kaiser-factorial/ducati-relay/v3_relay6/esp_relay_pinout.png

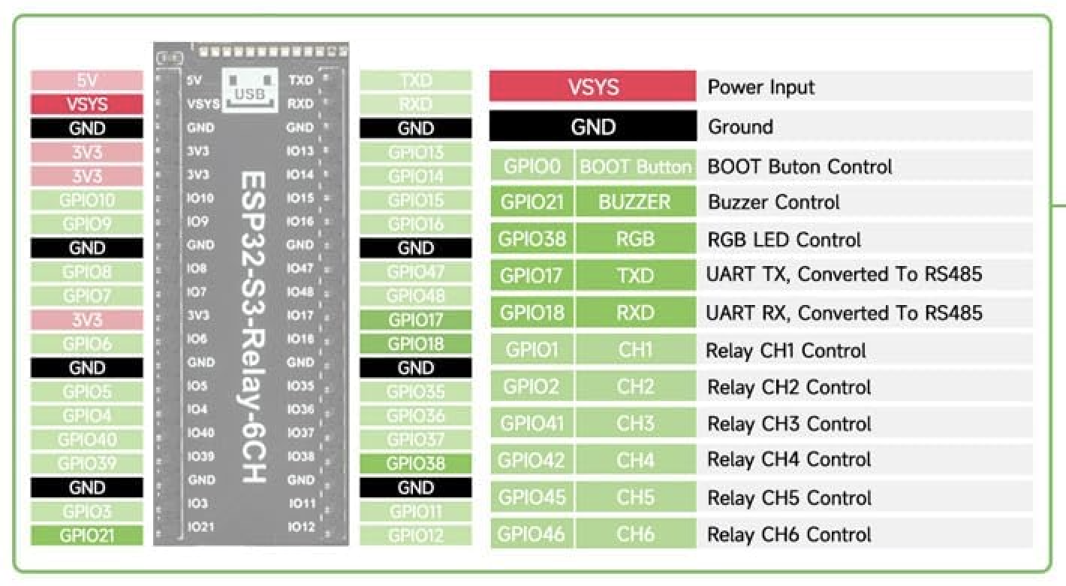
v3_relay6/esp_relay_pinout.png
