kaiser-factorial/ducati-relay/v3_relay6/can_hat_pinout.jpeg

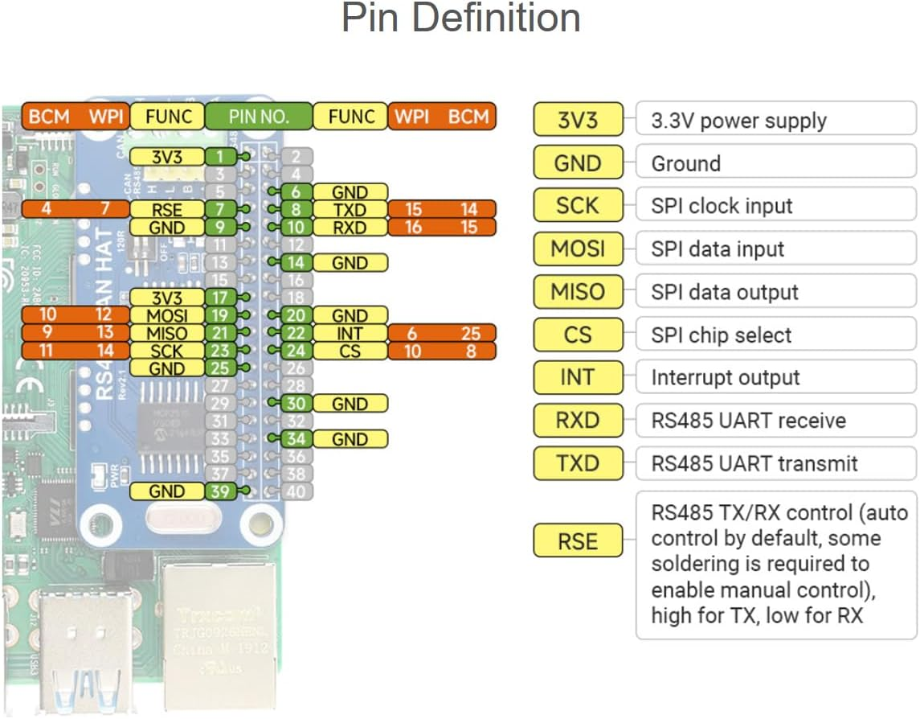
v3_relay6/can_hat_pinout.jpeg
