kaiser-factorial/ducati-relay/v3_relay6/front_CANhat_pinout.rtf

CAN --> ESP32

5V (2) --> 5V

3v3 (1) --> 3v3

MOSI (19) --> GPIO 7

MISO (21) --> GPIO 14

SCK (23) --> GPIO 6

GND (25) --> GND

INT (22) --> GPIO 15

CS (24) --> GPIO 16
