kaiser-factorial/ducati-relay/v3_relay6/esp_relay.jpeg

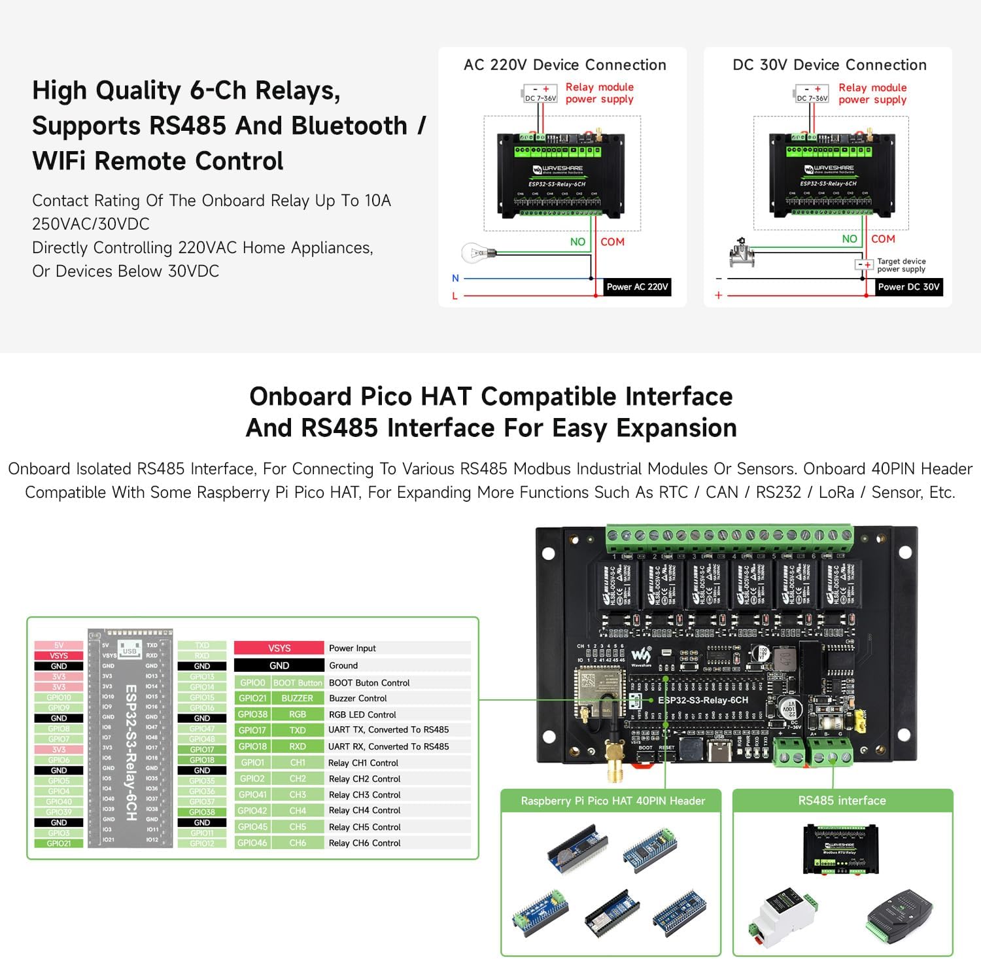
v3_relay6/esp_relay.jpeg
