kaiser-factorial/ducati-relay/(commit log)

2026-06-09 add v2 bike firmware for ESP-A and ESP-B
    ESP-A: 7 buttons (4 toggle, 1 momentary), 4 local front relays, CAN commands
    to ESP-B for turn signals and stereo; ignition-off shuts down all outputs;
    turn signals are mutually exclusive; starter has ignition interlock; receives
    ESP-B status and stubs ECU telemetry receive path.
    ESP-B: 4 rear relays with software turn-signal flash (500ms half-period),
    brake light stub (disabled, ECU_BRAKE_CAN_ID = 0x000 until rusEFI IDs
    confirmed), logical/physical relay state split, status broadcast on 0x160.
    Both sketches keep the same debug logging style as v1.
2026-06-09 fix CAN ID conflicts and add rusEFI telemetry parsing
    Move ESP-A command IDs from 0x100–0x102 to 0x300–0x302 to avoid collision
    with rusEFI's TunerStudio-over-CAN (0x100, 0x102). Update ESP-B relay table
    to match.
    Add ECU telemetry parsing in ESP-A's handleIncoming(): RPM (0x201), TPS
    (0x202), coolant temp (0x203), battery voltage (0x204), gear (0x200) with
    correct little-endian decode and scaling from rusEFI_CAN_verbose.dbc.
    Heartbeat now logs live ECU values. Display rendering remains a TODO pending
    dashboard hardware selection.
    Update SPEC.md: add confirmed rusEFI CAN ID table and BASE0–BASE4 payload
    decode reference; correct the ID plan (was assuming 0x600–0x6FF, actual is
    0x20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
    [esp32_a_bike.ino, esp32_b_bike.ino]
2026-06-09 update SPEC to reflect v2 implemented state
    - Rename "Target Architecture" to "Phase 2: Bike Firmware (IN PROGRESS)"
    - Replace "Planned Functions" with actual implemented button/relay table
    including GPIO assignments, toggle/momentary behaviors, CAN ID per relay,
    flash mode, ignition-off cascade, and starter interlock note
    - Fix Phase 1 sketch paths to v1/ subdirectory
    - Brake light relay documented as wired but disabled pending ECU CAN ID
2026-06-09 add v1.5 firmware: 4 buttons on ESP-A, 4 relays + potentiometer on ESP-B
    Builds on v1 practice rig. ESP-A gains a 4th button on GPIO 14 and listens
    for ESP-B's pot-selection broadcast (CAN 0x110). ESP-B gains a 4th relay on
    GPIO 25, reads a pot on GPIO 34 (zones 0-3), broadcasts the selected relay
    over CAN 0x110, and activates the corresponding relay independently of any
    button commands (relay is ON if btn-cmd OR pot selects it).
2026-06-09 update v1.5 ESP-A button pins to 32, 33, 25, 26
2026-06-09 add relay outputs to ESP-A v1.5 (GPIO 27, 14, 16, 17)
    Each button now drives a local relay directly in addition to sending a CAN
    command to ESP-B. Button 1-4 (GPIO 32/33/25/26) map to Relay 1-4
    (GPIO 27/14/16/17) respectively.
2026-06-09 add v1.5 section and board pin mapping to SPEC
    Adds Phase 1.5 section with CAN protocol table and full ESP32 DevKit v1
    pin mapping for both boards (left + right headers, top-to-bottom), noting
    all used pins and flagging input-only, strapping, and flash pins. Also
    updates Repository Layout to include v1.5/.
2026-06-09 remap ESP-A v1.5 relay pins: Ch1=17, Ch2=16, Ch3=14, Ch4=27
2026-06-09 replace potentiometer with brake switch on ESP-B v1.5
    ESP-B now reads a brake switch (GPIO 26, INPUT_PULLUP) instead of a
    potentiometer. Brake state is broadcast over CAN 0x110 (0x01=applied,
    0x00=released). ESP-A receives 0x110 and logs brake state. Pot-based
    relay selection logic removed entirely.
    [esp32_a_button_sender.ino, esp32_b_relay_receiver.ino]
2026-06-09 add relay wiring diagram SVG for ESP-A front 4-relay circuit
2026-06-09 fix stale comment in ESP-A v1.5 (pot -> brake)
    [esp32_a_button_sender.ino]
2026-06-09 add ESP-B rear relay wiring diagram (SVG)
    Shows 4-relay load circuit for ESP-B v1.5: GPIO 4/32/33/25 relay
    outputs, daisy-chained +12V COM rail, brake switch on GPIO 26, and
    GND return bus to battery negative.
2026-06-09 add passive piezo buzzer feedback to ESP-B (GPIO 13)
    Each relay ON event plays a distinct tone via tone() so you can hear
    which relay fired: 880/1047/1319/1568 Hz for relays 1–4.
    [esp32_b_relay_receiver.ino]
2026-06-09 simplify ESP-B buzzer to single fixed tone
    One relay in practice rig, so no need for per-channel pitches.
    Single 1 kHz / 80 ms beep on any relay ON event.
    [esp32_b_relay_receiver.ino]
2026-06-09 increase buzzer duration to 3000 ms
    [esp32_b_relay_receiver.ino]
2026-06-09 redesign v1.5 CAN flow to emphasize inter-ESP communication
    ESP-A relays now fire ONLY after receiving a CAN response from ESP-B,
    making the CAN roundtrip visible. Ch1 (GPIO 32) is one-way: A sends to B
    (relay + buzzer). Ch2-4 are request/response: A sends, B fires relay and
    confirms back, then A fires its local relay. ESP-B's push button sends
    CAN 0x110 to drive ESP-A's Ch1 relay — so each side controls something on
    the other. Onboard LED (GPIO 2) on both boards blinks on every incoming
    CAN message.
    [esp32_a_button_sender.ino, esp32_b_relay_receiver.ino]
2026-06-09 fix serial log accuracy in both sketches
    ESP-A: Ch1 button now logs "(one-way)" instead of "(awaiting response)"
    since ESP-B never responds to the Ch1 button press.
    ESP-B: "LED blink" only printed in the matched branch, not for ignored packets.
    [esp32_a_button_sender.ino, esp32_b_relay_receiver.ino]
2026-06-09 update SPEC to reflect v1.5 final design + add arduino-cli how-to
    - Rewrites Phase 1.5 intro to describe the request/response CAN design
    and the one-way Ch1 / cross-board control philosophy
    - Updates CAN protocol table with all 8 IDs (0x100-0x103, 0x110-0x113)
    - Updates pin mapping: GPIO 13 buzzer on ESP-B, GPIO 26 push button,
    GPIO 2 CAN receive LED on both boards
    - Updates repo layout descriptions for v1.5 sketches + adds SVG entries
    - Adds Build & Flash section with arduino-cli setup, compile, upload,
    and monitor commands
2026-06-09 rename v1.5 sketches to esp_a_front and esp_b_back
    Arduino requires folder name == .ino filename; both renamed together.
    Updated SPEC.md paths to match.
2026-06-09 ignore *.log and sample.txt
2026-06-09 Add full system wiring diagrams and update v1.5 MCP2515 pins
2026-06-18 feat: add v3 relay hardware documentation and implement rear module BLE provisioning bootstrap
2026-06-18 docs(v4): add rear bootstrap documentation + CAN bus guidance; fix LED/OTA firmware
    Document the full v4 rear-module bootstrap bring-up on the ESP32_Relay X4 board:
    - BLE provisioning + OTA workflow, build settings, and first-time USB flash
    - Troubleshooting table for every issue hit during bring-up (NETWORK_PROV_*
    rename, min_spiffs partition, IO0 download-mode, no LED on GPIO2, brownout,
    wrong board target, OTA password prompt, mDNS)
    - Forward-looking MCP2515 CAN bus section distilling v1-v3 lessons (crystal
    freq, transceiver voltage, termination, rusEFI CAN IDs, GPIO23 conflict)
    Firmware: switch to NETWORK_PROV_* (core 3.x), dual status LEDs on GPIO23 +
    GPIO13 (board has no LED on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
    [rear_bootstrap.ino]
